arkorobotics/L1DemosceneBoard/L1Demo-C-example/L1DemoProto.X/README.md

# Layer 1 demo board code

This is where I'll be dumping my L1 Demo code as I slowly cobble it together.
See https://github.com/arkorobotics/L1DemosceneBoard for more examples.
