arkorobotics/L1DemosceneBoard/L1Demo-PCB/arko_l1demo_partlist.xlsx

Partlist
Exported | from | L1Demoscene_v4.brd | at | 2014-12-15 | 7:47:11 | PM
EAGLE | Version | 6.5.0 | Copyright | (c) | 1988-2013 | CadSoft
Assembly | variant:
Part | Value | Package | Library | Position | (mil) | Orientation
C1 | 0.1uF | 0603-CAP | SparkFun-Capacitors | (550 | 1290) | R90
C2 | 10uF | EIA3216 | SparkFun-Capacitors | (120 | 220) | R0
C3 | EIA3216 | SparkFun-Capacitors | (1430 | 1790) | R270
C4 | SMC_A | dp_devices | (270 | 1690) | R90
C5 | SMC_A | dp_devices | (370 | 1690) | R90
C6 | 18pF | 0603-CAP | SparkFun-Capacitors | (90 | 460) | R180
C7 | 18pF | 0603-CAP | SparkFun-Capacitors | (90 | 780) | R0
C8 | 0.1uF | 0603-CAP | SparkFun-Capacitors | (750 | 980) | R180
C9 | 0.1uF | 0603-CAP | SparkFun-Capacitors | (90 | 860) | R180
C10 | 0.1uF | 0603-CAP | SparkFun-Capacitors | (480 | 190) | R180
C11 | 0.1uF | 0603-CAP | SparkFun-Capacitors | (870 | 590) | R90
IC2 | REG1117 | SOT223 | burr-brown | (370 | 1390) | R180
L1 | 30Ohm,1.8A | 603 | SparkFun-Passives | (750 | 1050) | R180
PWR | LED-603 | dp_devices | (530 | 1690) | R180
R1 | 2K | 0603-RES | SparkFun-Resistors | (1130 | 1150) | R0
R2 | 10K | 0603-RES | SparkFun-Resistors | (90 | 380) | R0
R3 | 470 | 0603-RES | SparkFun-Resistors | (90 | 310) | R180
R6 | 10k | 0603-RES | SparkFun-Resistors | (1030 | 1660) | R90
R7 | 10k | 0603-RES | SparkFun-Resistors | (930 | 1660) | R90
R18 | 10k | 0603-RES | SparkFun-Resistors | (1130 | 1660) | R90
R27 | 1k | 0603-RES | SparkFun-Resistors | (460 | 1690) | R270
R28 | 10k | 0603-RES | SparkFun-Resistors | (1230 | 1660) | R90
RESET | SWITCH-MOMENTARY-2-SMD-1101NE | TACTILE-SWITCH-1101NE | SparkFun-Electromechanical | (930 | 80) | R180
RN1 | 560 | EXB2HV | resistor-dil | (1130 | 570) | R270
RN2 | 270 | EXB2HV | resistor-dil | (1350 | 570) | R270
RN3 | 560 | EXB2HV | resistor-dil | (1130 | 890) | R270
RN4 | 270 | EXB2HV | resistor-dil | (1350 | 890) | R270
RN5 | 560 | EXB2HV | resistor-dil | (1130 | 250) | R270
RN6 | 270 | EXB2HV | resistor-dil | (1350 | 250) | R270
RN7 | 2K | EXB2HV | resistor-dil | (1130 | 1290) | R270
RN8 | 1K | EXB2HV | resistor-dil | (1350 | 1290) | R270
S3 | SWITCH-SPST-SMD-A | SparkFun-Electromechanical | (60 | 1670) | R90
U2 | PIC24FXXXDAX06 | PIC24FXXX_TQFP64 | SparkFun-DigitalIC | (510 | 510) | R90
U3 | USB-AB-MICRO-SMD | SparkFun-Connectors | (80 | 1120) | R0
Y1 | CRYSTAL-SMD-5X3 | SparkFun-FreqCtrl | (90 | 620) | R270
