arkorobotics/L1DemosceneBoard/L1Demo-PCB/L1Demoboard_BOM.xlsx

Part | Value | Device | Package | Description | Link | QTY | 100 Boards | 50 Boards
C1,C8,C9,C10,C11 | 0.1uF | CAP0603-CAP | 0603-CAP | Capacitor | http://www.digikey.com/product-detail/en/GRM188R71C104KA01D/490-1532-1-ND/587771 | 5 | 3.00 | 1.76
C2,C3,C4,C5 | 10uF | CAP_POL1206 | EIA3216 | Capacitor | http://www.digikey.com/product-detail/en/T491A106K010AT/399-3684-1-ND/819009 | 4 | 53.87 | 33.68 | EXPENSIVE
C6,C7 | 18pF | CAP0603-CAP | 0603-CAP | Capacitor | http://www.digikey.com/product-detail/en/GRM1885C1H180JA01D/490-1409-1-ND/587631 | 2 | 3.82 | 1.91
IC2 | REG1117 | REG1117 | SOT223 | 800mA | http://www.digikey.com/product-detail/en/LM1117MPX-3.3%2FNOPB/LM1117MPX-3.3%2FNOPBCT-ND/1010516 | 1 | 115.16 | 65.80 | EXPENSIVE
J2 | CON_HEADER_1X02-PTH | CON_HEADER_1X02-PTH | M1X2 |  | http://www.digikey.com/product-detail/en/67997-210HLF/609-3236-ND/1878541 | 1 | 10.40 | 5.60
J3 | CON_HEADER_2X04-PTH | CON_HEADER_2X04-PTH | M2X5 |  | http://www.digikey.com/product-detail/en/67997-210HLF/609-3236-ND/1878541 | 1 | 35.40 | 18.47
JP1 | AUDIO-JACKPTH | AUDIO-JACK | 3.5mm | Audio | http://www.digikey.com/product-detail/en/SJ1-3525N/CP1-3525N-ND/738687 | 1 | 0.00 | 0.00 | EXPENSIVE
JP2 | M06SIP | 1X06 | Header | 6 | http://www.digikey.com/product-detail/en/961106-5604-AR/3M9471-ND/2071512 | 1 | 32.20 | 16.80
L1 | 30Ohm,1.8A | INDUCTOR0402 | C0402 | Inductors | http://www.digikey.com/product-detail/en/ELJ-PF2N7DFB/PCD1890CT-ND/762119 | 1 | 13.06 | 6.99
PWR | LED-0603 | LED-603 | Light | Emitting | http://www.digikey.com/product-detail/en/LTST-C191KRKT/160-1447-1-ND/386836 | 1 | 12.96 | 11.90
R1 | 2K | RESISTOR0603-RES | 0603-RES | Resistor | http://www.digikey.com/scripts/DkSearch/dksus.dll?Detail&itemSeq=157261085&uq=635461678349767670 | 1 | 1.14 | 0.75
R2,R6,R7,R18,R28 | 10K | RESISTOR0603-RES | 0603-RES | Resistor | http://www.digikey.com/product-detail/en/RC0603JR-0710KL/311-10KGRCT-ND/729647 | 5 | 0.45 | 0.40
R3 | 470 | RESISTOR0603-RES | 0603-RES | Resistor | http://www.digikey.com/product-detail/en/RC0603JR-07470RL/311-470GRCT-ND/729738 | 1 | 0.45 | 0.40
R27 | 1k | RESISTOR0603-RES | 0603-RES | Resistor | http://www.digikey.com/product-detail/en/RC0603FR-071KL/311-1.00KHRCT-ND/729790 | 1 | 0.60 | 0.54
RN1,RN3,RN5 | 560 | 8R-NEXB2HV | EXB2HV | DIL | http://www.digikey.com/product-detail/en/EXB-2HV561JV/Y1561CT-ND/285378 | 3 | 39.37 | 25.32
RN2,RN4,RN6 | 270 | 8R-NEXB2HV | EXB2HV | DIL | http://www.digikey.com/product-detail/en/EXB-2HV271JV/Y1271CT-ND/285374 | 3 | 39.37 | 25.32
RN7 | 2K | 8R-NEXB2HV | EXB2HV | DIL | http://www.digikey.com/product-detail/en/EXB-2HV222JV/Y1222CT-ND/285385 | 1 | 16.88 | 10.94
RN8 | 1K | 8R-NEXB2HV | EXB2HV | DIL | http://www.digikey.com/scripts/DkSearch/dksus.dll?Detail&itemSeq=157261141&uq=635461681129495907 | 1 | 16.88 | 10.94
S3 | SWITCH-SPDT-SMD-A | SWITCH-SPST-SMD-A | SPDT | Switch | http://www.digikey.com/scripts/DkSearch/dksus.dll?Detail&itemSeq=157261168&uq=635461682841907907 | 1 | 62.26 | 32.69
U$1 | DB15 | DB15 | DB15 | DB15 | http://www.digikey.com/product-detail/en/1734344-1/A35119-ND/1279832 | 1 | 0.00 | 0.00
U2 | PIC24FJ256DA206 | PIC24FXXXDAX06 | PIC24FXXX_TQFP64 | PIC24FXXXDAX06 | http://www.mouser.com/Search/ProductDetail.aspx | 1 | 584.00 | 322.50 | EXPENSIVE
U3 | USB-AB | USB-AB-MICRO-SMD | This | is | http://www.digikey.com/product-detail/en/10104111-0001LF/609-4053-1-ND/2350359 | 1 | 56.87 | 29.67
Y1 | CRYSTAL5X3 | CRYSTAL-SMD-5X3 | Various | standard | http://www.digikey.com/product-search/en?KeyWords=535-9720-1-ND&WT.z_header=search_go | 1 | 76.00 | 42.94
 | Push Switch |  |  |  | http://www.digikey.com/product-detail/en/RS-282G05A3-SM%20RT/CKN10384CT-ND/2747203 | 1 | 55.00 | 30.25 | EXPENSIVE
 |  |  |  |  |  |  | Total part cost of 100 Boards | Total part cost of 50 Boards
 |  |  |  |  |  |  | 1229.14 | 695.57
 |  |  |  |  |  |  | Part cost per board | Part cost per board
 |  |  |  |  |  |  | 12.29144 | 13.9114
 |  |  |  |  |  |  | PNP total cost | PNP total cost
 |  |  |  |  |  |  | 900 | 525
 |  |  |  |  |  |  | PNP cost per board | PNP cost per board
 |  |  |  |  |  |  | 6.5 | 10.5
 |  |  |  |  |  |  | PCB cost | PCB cost
 |  |  |  |  |  |  | 198 | 70
 |  |  |  |  |  |  | Total cost to manufacture 100 | Total cost to manufacture 50
 |  |  |  |  |  |  | 2327.14 | 1290.57
 |  |  |  |  |  |  | Total cost per board | Total cost per board
 |  |  |  |  |  |  | 23.27144 | 25.8114
