arkorobotics/L1DemosceneBoard/L1Demo-PCB/L1Demoscene_v4.pdf

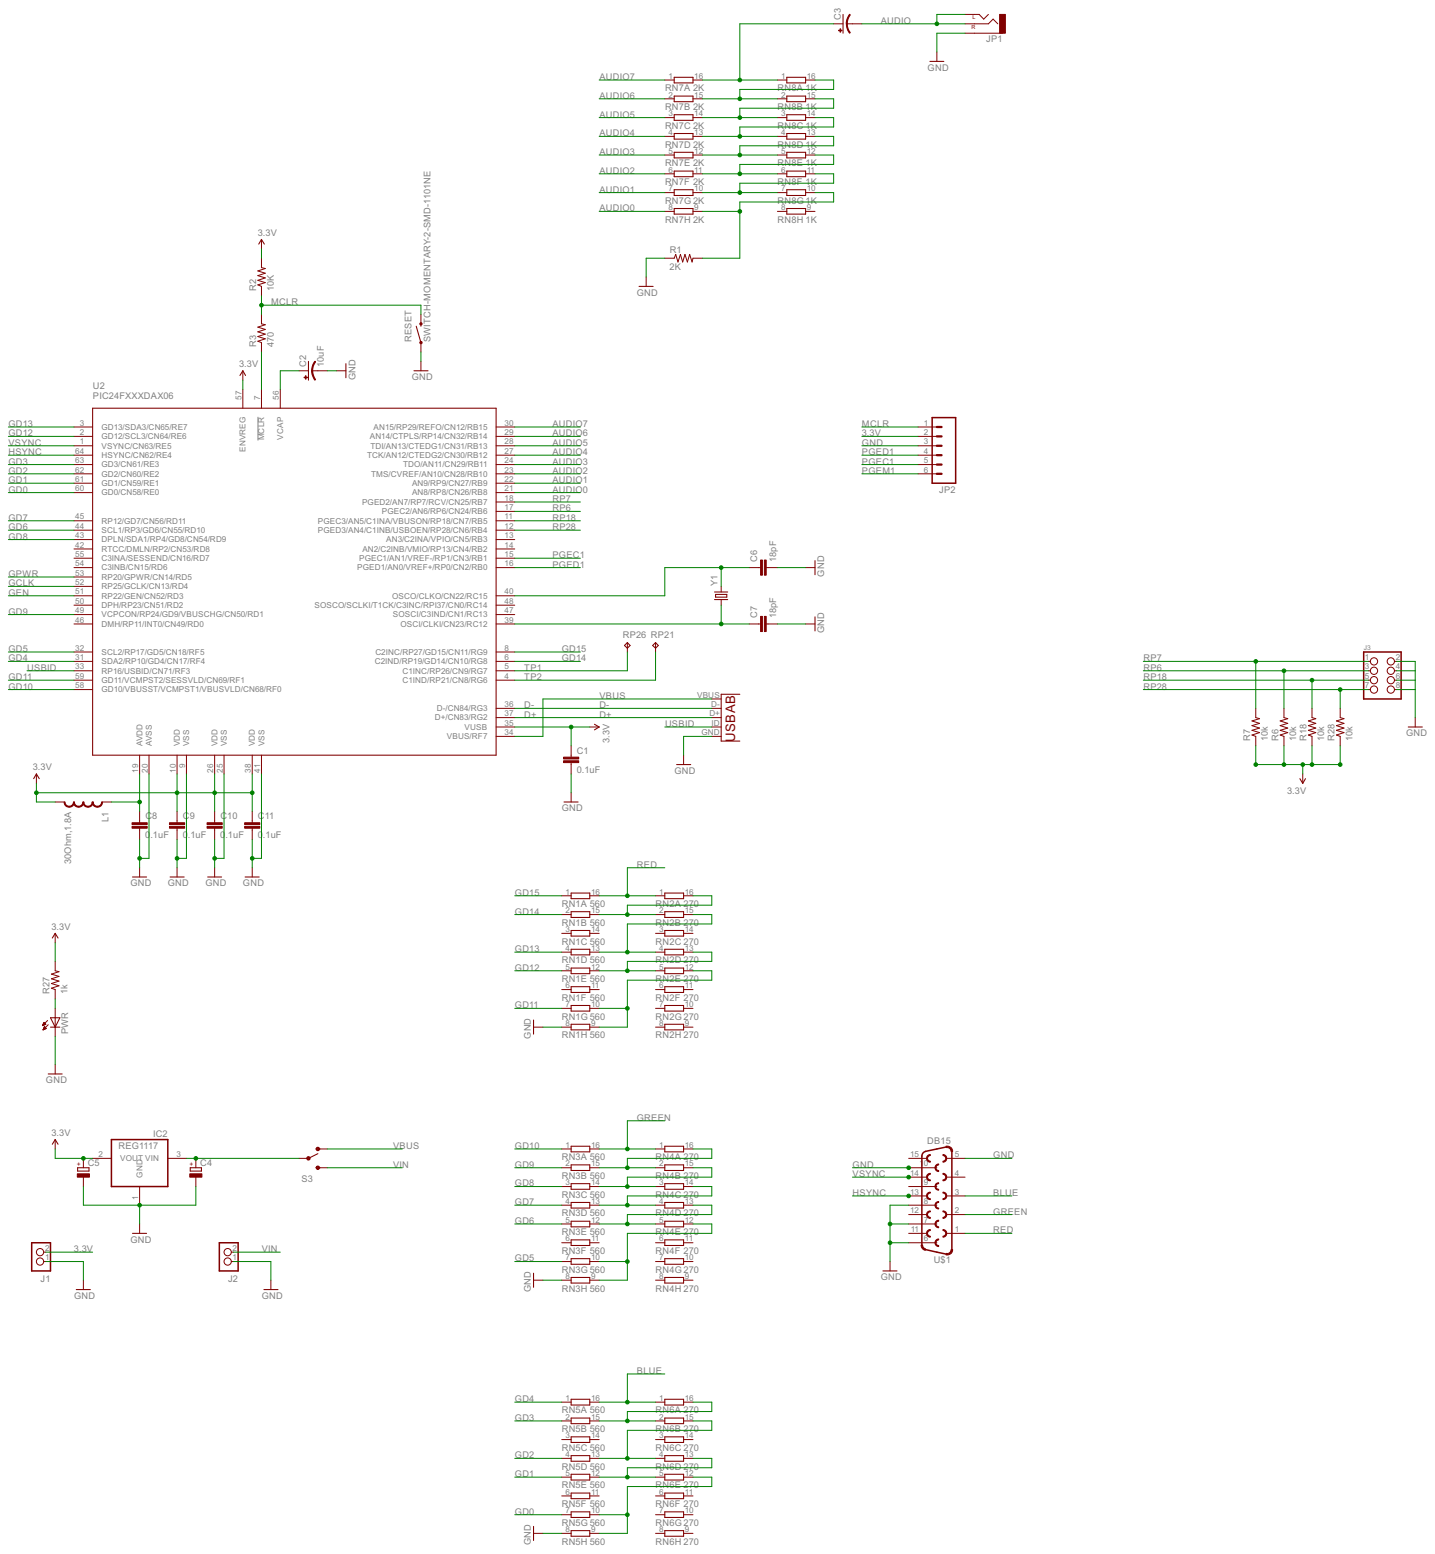
[picture p1: page 1]
