arkorobotics/L1DemosceneBoard/L1Demo-PCB/L1Demoscene_v4.brd

## EAGLE design L1Demo-PCB/L1Demoscene_v4.brd (2015-01-01)

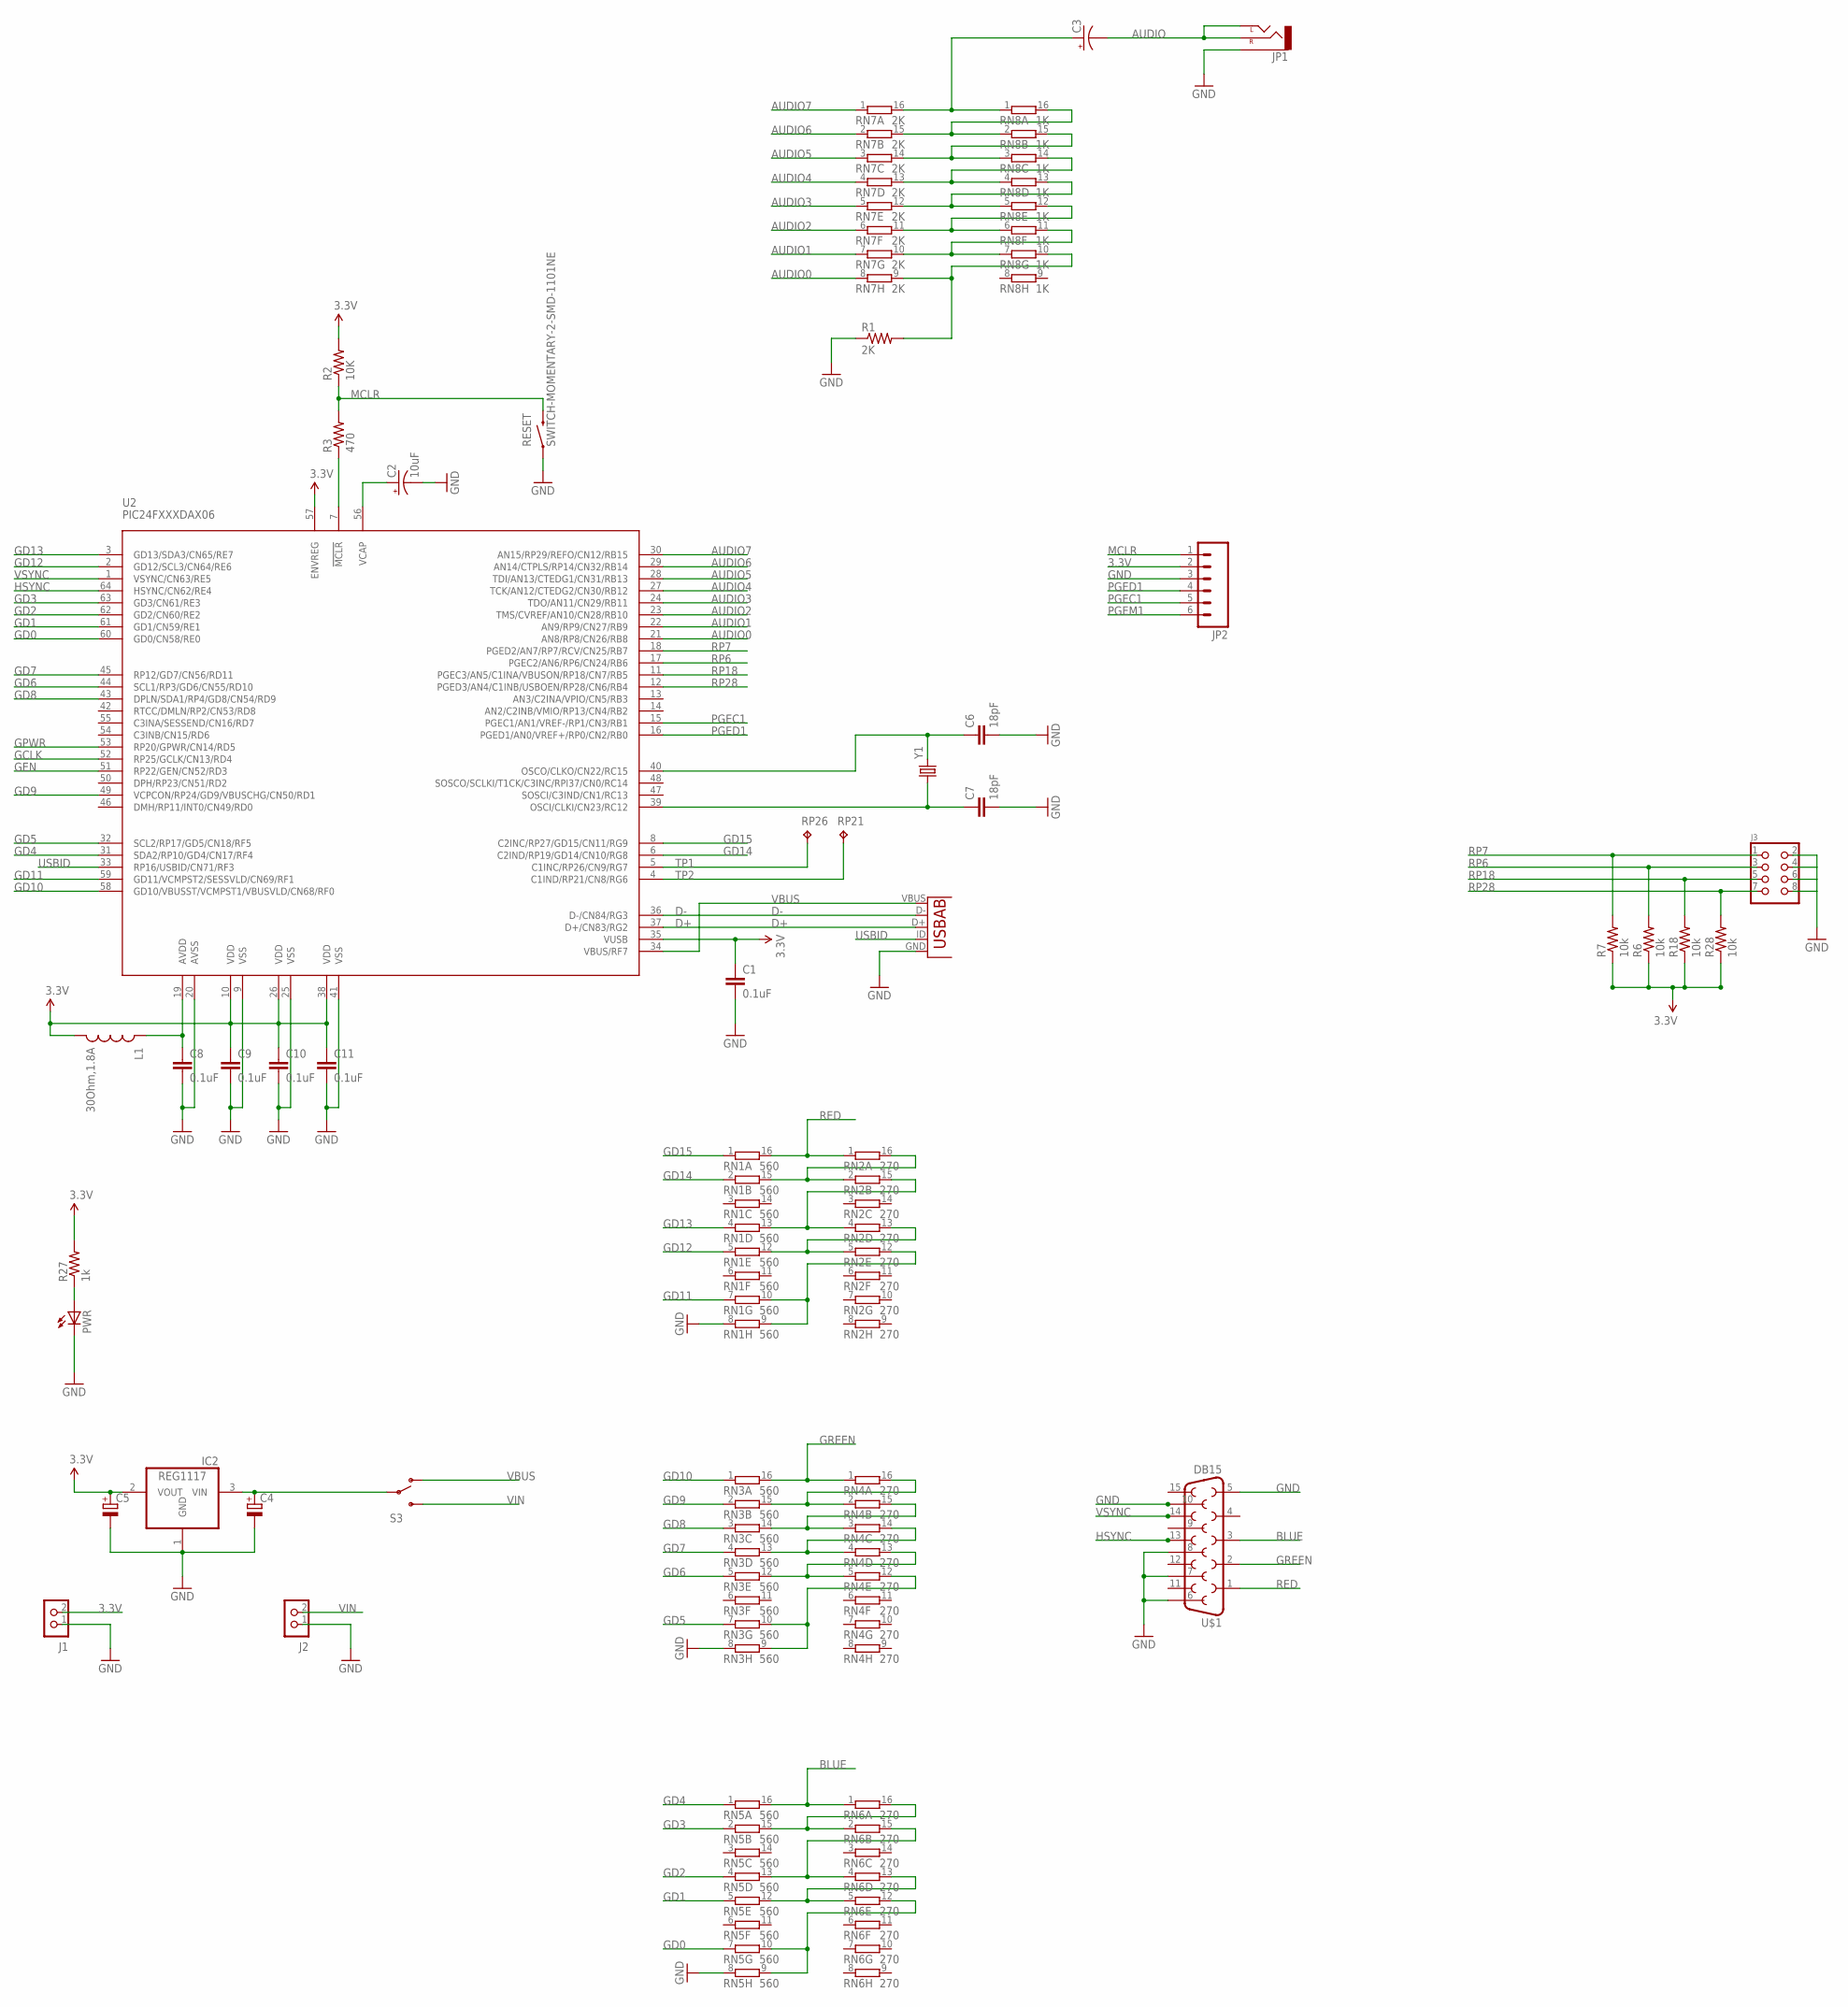
[picture p2: schematic L1Demoscene_v4.sch]

Parts:
C1, C8, C9, C10, C11: 0.1uF; 0603-CAP
C2: 10uF; EIA3216
C3: CAP_POL1206; EIA3216
C4, C5: CAPACITOR_POL-SMC_A; SMC_A
C6, C7: 18pF; 0603-CAP
IC2: REG1117; SOT223
J1, J2: CON_HEADER_1X02-PTH; M1X2
J3: CON_HEADER_2X04-PTH; M2X4
JP1: AUDIO-JACKPTH; AUDIO-JACK
JP2: M06SIP; 1X06
L1: 30Ohm,1.8A; 0603
PWR: LED-0603; LED-603
R1: 2K; 0603-RES
R2: 10K; 0603-RES
R3: 470; 0603-RES
R6, R7, R18, R28: 10k; 0603-RES
R27: 1k; 0603-RES
RESET: SWITCH-MOMENTARY-2-SMD-1101NE; TACTILE-SWITCH-1101NE
RN1, RN3, RN5: 560; EXB2HV
RN2, RN4, RN6: 270; EXB2HV
RN7: 2K; EXB2HV
RN8: 1K; EXB2HV
RP21, RP26: TPTP06R; TP06R
S3: SWITCH-SPDT-SMD-A; SWITCH-SPST-SMD-A
U2: PIC24FXXXDAX06; PIC24FXXX_TQFP64
U3: USB-AB; USB-AB-MICRO-SMD
U$1: DB15
Y1: CRYSTAL5X3; CRYSTAL-SMD-5X3

Connections:
3.3V: C1.1, C5.+, C9.1, C10.1, C11.1, IC2.2 (VOUT), J1.2, JP2.2, L1.2, R2.2, R6.1, R7.1, R18.1, R27.2, R28.1, U2.10 (VDD), U2.26 (VDD), U2.35 (VUSB), U2.38 (VDD), U2.57 (ENVREG)
AUDIO: C3.C (-), JP1.RING (RIGHT), JP1.TIP (LEFT)
AUDIO0: RN7.8 (1), U2.21 (AN8/RP8/CN26/RB8)
AUDIO1: RN7.7 (1), U2.22 (AN9/RP9/CN27/RB9)
AUDIO2: RN7.6 (1), U2.23 (TMS/CVREF/AN10/CN28/RB10)
AUDIO3: RN7.5 (1), U2.24 (TDO/AN11/CN29/RB11)
AUDIO4: RN7.4 (1), U2.27 (TCK/AN12/CTEDG2/CN30/RB12)
AUDIO5: RN7.3 (1), U2.28 (TDI/AN13/CTEDG1/CN31/RB13)
AUDIO6: RN7.2 (1), U2.29 (AN14/CTPLS/RP14/CN32/RB14)
AUDIO7: RN7.1, U2.30 (AN15/RP29/REFO/CN12/RB15)
BLUE: RN5.16 (2), RN6.1, U$1.3
D+: U2.37 (D+/CN83/RG2), U3.D+
D-: U2.36 (D-/CN84/RG3), U3.D-
GCLK: U2.52 (RP25/GCLK/CN13/RD4)
GD0: RN5.7 (1), U2.60 (GD0/CN58/RE0)
GD1: RN5.5 (1), U2.61 (GD1/CN59/RE1)
GD2: RN5.4 (1), U2.62 (GD2/CN60/RE2)
GD3: RN5.2 (1), U2.63 (GD3/CN61/RE3)
GD4: RN5.1, U2.31 (SDA2/RP10/GD4/CN17/RF4)
GD5: RN3.7 (1), U2.32 (SCL2/RP17/GD5/CN18/RF5)
GD6: RN3.5 (1), U2.44 (SCL1/RP3/GD6/CN55/RD10)
GD7: RN3.4 (1), U2.45 (RP12/GD7/CN56/RD11)
GD8: RN3.3 (1), U2.43 (DPLN/SDA1/RP4/GD8/CN54/RD9)
GD9: RN3.2 (1), U2.49 (VCPCON/RP24/GD9/VBUSCHG/CN50/RD1)
GD10: RN3.1, U2.58 (GD10/VBUSST/VCMPST1/VBUSVLD/CN68/RF0)
GD11: RN1.7 (1), U2.59 (GD11/VCMPST2/SESSVLD/CN69/RF1)
GD12: RN1.5 (1), U2.2 (GD12/SCL3/CN64/RE6)
GD13: RN1.4 (1), U2.3 (GD13/SDA3/CN65/RE7)
GD14: RN1.2 (1), U2.6 (C2IND/RP19/GD14/CN10/RG8)
GD15: RN1.1, U2.8 (C2INC/RP27/GD15/CN11/RG9)
GEN: U2.51 (RP22/GEN/CN52/RD3)
GND: C1.2, C2.C (-), C4.-, C5.-, C6.2, C7.2, C8.2, C9.2, C10.2, C11.2, IC2.1 (GND), J1.1, J2.1, J3.2, J3.4, J3.6, J3.8, JP1.SLEEVE, JP2.3, PWR.C, R1.1, RESET.P$1 (1), RN1.8 (1), RN3.8 (1), RN5.8 (1), U2.9 (VSS), U2.20 (AVSS), U2.25 (VSS), U2.41 (VSS), U3.GND, U$1.5, U$1.6, U$1.7, U$1.8, U$1.10
GPWR: U2.53 (RP20/GPWR/CN14/RD5)
GREEN: RN3.16 (2), RN4.1, U$1.2
HSYNC: U2.64 (HSYNC/CN62/RE4), U$1.13
MCLR: JP2.1, R2.1, R3.2, RESET.P$2 (2)
unnamed: C8.1, L1.1, U2.19 (AVDD)
unnamed: C3.A (+), RN7.16 (2), RN8.1
unnamed: C7.1, U2.39 (OSCI/CLKI/CN23/RC12), Y1.1
unnamed: R3.1, U2.7 (!MCLR)
unnamed: RN7.15 (2), RN8.2 (1), RN8.16 (2)
unnamed: RN7.14 (2), RN8.3 (1), RN8.15 (2)
unnamed: C4.+, IC2.3 (VIN), S3.2
unnamed: C2.A (+), U2.56 (VCAP)
unnamed: RN7.13 (2), RN8.4 (1), RN8.14 (2)
unnamed: PWR.A, R27.1
unnamed: RN7.12 (2), RN8.5 (1), RN8.13 (2)
unnamed: RN7.11 (2), RN8.6 (1), RN8.12 (2)
unnamed: RN7.10 (2), RN8.7 (1), RN8.11 (2)
unnamed: RN3.15 (2), RN4.2 (1), RN4.16 (2)
unnamed: RN3.14 (2), RN4.3 (1), RN4.15 (2)
unnamed: RN3.13 (2), RN4.4 (1), RN4.14 (2)
unnamed: RN3.12 (2), RN4.5 (1), RN4.13 (2)
unnamed: RN3.9 (2), RN3.10 (2), RN4.12 (2)
unnamed: R1.2, RN7.9 (2), RN8.10 (2)
unnamed: C6.1, U2.40 (OSCO/CLKO/CN22/RC15), Y1.3 (2)
unnamed: RN1.13 (2), RN2.4 (1), RN2.15 (2)
unnamed: RN1.15 (2), RN2.2 (1), RN2.16 (2)
unnamed: RN1.12 (2), RN2.5 (1), RN2.13 (2)
unnamed: RN1.9 (2), RN1.10 (2), RN2.12 (2)
unnamed: RN5.15 (2), RN6.2 (1), RN6.16 (2)
unnamed: RN5.13 (2), RN6.4 (1), RN6.15 (2)
unnamed: RN5.12 (2), RN6.5 (1), RN6.13 (2)
unnamed: RN5.9 (2), RN5.10 (2), RN6.12 (2)
PGEC1: JP2.5, U2.15 (PGEC1/AN1/VREF-/RP1/CN3/RB1)
PGED1: JP2.4, U2.16 (PGED1/AN0/VREF+/RP0/CN2/RB0)
PGEM1: JP2.6
RED: RN1.16 (2), RN2.1, U$1.1
RP6: J3.3, R6.2, U2.17 (PGEC2/AN6/RP6/CN24/RB6)
RP7: J3.1, R7.2, U2.18 (PGED2/AN7/RP7/RCV/CN25/RB7)
RP18: J3.5, R18.2, U2.11 (PGEC3/AN5/C1INA/VBUSON/RP18/CN7/RB5)
RP28: J3.7, R28.2, U2.12 (PGED3/AN4/C1INB/USBOEN/RP28/CN6/RB4)
TP1: RP26.TP, U2.5 (C1INC/RP26/CN9/RG7)
TP2: RP21.TP, U2.4 (C1IND/RP21/CN8/RG6)
USBID: U2.33 (RP16/USBID/CN71/RF3), U3.ID (USBID)
VBUS: S3.1 (O), U2.34 (VBUS/RF7), U3.VBUS
VIN: J2.2, S3.3 (S)
VSYNC: U2.1 (VSYNC/CN63/RE5), U$1.14

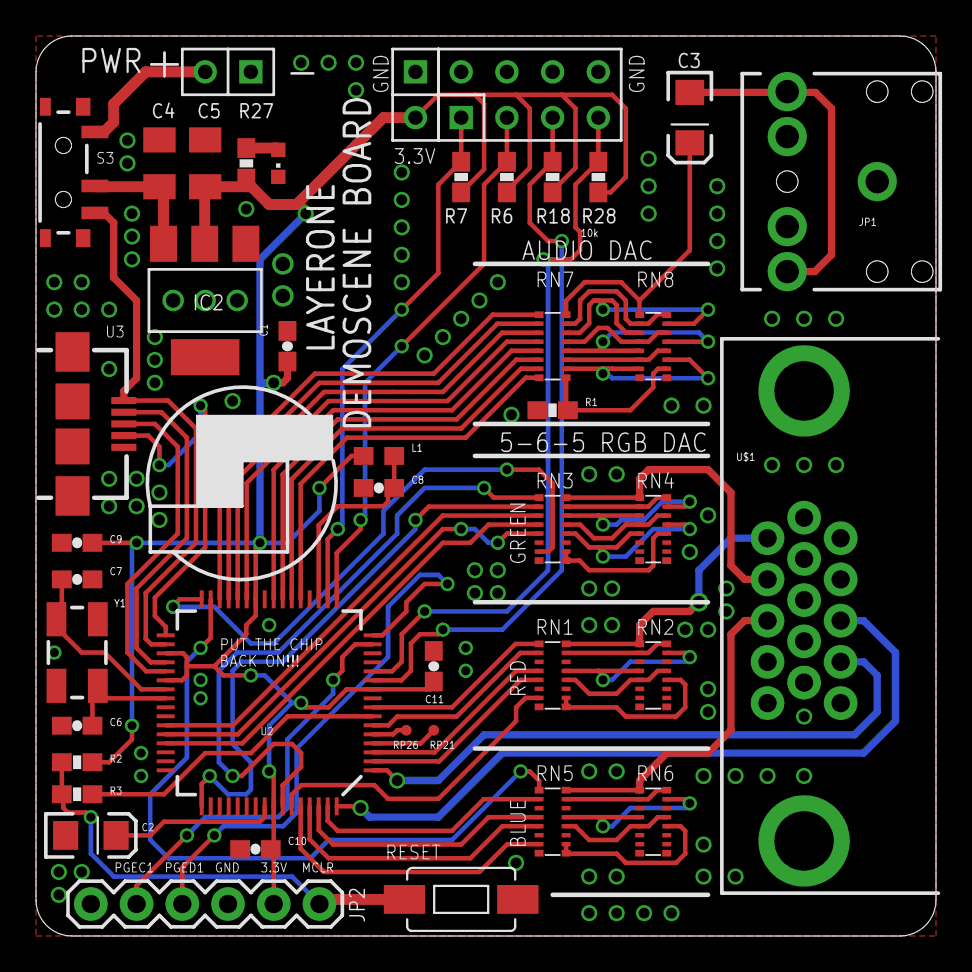
[picture p3: board L1Demoscene_v4.brd from above]

Board: 2 copper layers, 50.0 x 50.0 mm, 44 parts (0 on the bottom side), 74 nets.

Other parts of the board:
U$2: STM32-PROX_L1LOGO
