arkorobotics/L1DemosceneBoard/L1Demo-C-example/L1DemoProto.X/clut/main.c

#include <stdint.h>
#include <stdio.h>
#include <stdlib.h>
#include <xc.h>
#include <string.h>
#include <math.h>

#define  FCY    16000000UL    // Instruction cycle frequency, Hz
#include <libpic30.h>

_CONFIG1(FWDTEN_OFF & GWRP_OFF & GCP_OFF & JTAGEN_OFF)
_CONFIG2(POSCMOD_HS & FCKSM_CSDCMD & FNOSC_PRIPLL & PLL96MHZ_ON & PLLDIV_DIV2)
_CONFIG3(ALTPMP_ALTPMPEN & SOSCSEL_EC)

/*
   To change resolutions, use an X modeline generator like:
   http://xtiming.sourceforge.net/cgi-bin/xtiming.pl
   For example, 80x480@60Hz produces
   Modeline "80x480@61" 4.93 80 112 128 160 480 490 495 505
   Then we convert it to the values we need:

   4.93 is the pixel clock in MHz, we need to set CLOCKDIV to match.  To pick a
   divisor, use page 147 of the data sheet or, uh, this perl one-liner to
   generate all of them and pick one that's close:
   perl -e '$d = 1;  $x = 0; while($x < 128) { printf "%s %.2f\n",$x,96/$d;if($x < 64) { $d += 0.25; } elsif($x < 96) { $d += 0.50 } else { $d += 1 }; $x++}'

   The differences between: 80 112 128 160 480
   are H-porch, H-Pulse, H-width
   The differences between: 480 490 495 505
   are V-porch, V-Pulse, V-width

   Once these values are in, the monitor will display it but it will probably
   be misaligned (especially vertically).  Play with VENST_FUDGE and
   HENST_FUDGE to fix this.
*/

#define HOR_RES 640UL
#define VER_RES 480UL
#define HOR_FRONT_PORCH 16
#define HOR_PULSE_WIDTH 96
#define HOR_BACK_PORCH  48
#define VER_FRONT_PORCH 10
#define VER_PULSE_WIDTH 2
#define VER_BACK_PORCH  33
#define BPP 1
#define CLOCKDIV 11
#define VENST_FUDGE 0
#define HENST_FUDGE 0
#define VSPOL 0 /* sync polarities */
#define HSPOL 0

#define CHR_FGCOLOR		0x5000
#define CHR_BGCOLOR		0x5100
#define CHR_FONTBASE		0x5200
#define CHR_PRINTCHAR		0x5300
#define CHR_TXTAREASTART	0x5800
#define CHR_TXTAREAEND		0x5900
#define CHR_PRINTPOS		0x5A00
#define RCC_SRCADDR	 	0x6200
#define RCC_DESTADDR	 	0x6300
#define RCC_RECTSIZE	 	0x6400
#define RCC_COLOR	 	0x6600
#define RCC_STARTCOPY	 	0x6700
#define IPU_SRCADDR		0x7100
#define IPU_DESTADDR	 	0x7200
#define IPU_DECOMPRESS	 	0x7400

#define GFX_BUFFER_SIZE (HOR_RES * VER_RES / (8/BPP))
__eds__ uint8_t GFXDisplayBuffer[2][GFX_BUFFER_SIZE] __attribute__((eds, section("DISPLAY"), address(0x1000)));

void config_graphics(void) {
	_G1CLKSEL = 1;
	_GCLKDIV = CLOCKDIV;

	G1DPADRL = (unsigned long)(GFXDisplayBuffer) & 0xFFFF;
	G1DPADRH = (unsigned long)(GFXDisplayBuffer) >>16 & 0xFF;
	G1W1ADRL = (unsigned long)(GFXDisplayBuffer) & 0xFFFF;
	G1W1ADRH = (unsigned long)(GFXDisplayBuffer) >>16 & 0xFF;
	G1W2ADRL = (unsigned long)(GFXDisplayBuffer) & 0xFFFF;
	G1W2ADRH = (unsigned long)(GFXDisplayBuffer) >>16 & 0xFF;

	_GDBEN = 0xFFFF;

	// Using PIC24F manual section 43 page 37-38
	_DPMODE = 1;      /* TFT */
	_GDBEN = 0xFFFF;
	_DPW = _PUW = HOR_RES; // Work area and FB size so GPU works
	_DPH = _PUH = VER_RES;
	_DPWT = HOR_FRONT_PORCH + HOR_PULSE_WIDTH + HOR_BACK_PORCH + HOR_RES;
	_DPHT = VER_FRONT_PORCH + VER_PULSE_WIDTH + VER_BACK_PORCH + VER_RES;
	_DPCLKPOL = 0;
	_DPENOE = 0;
	_DPENPOL = 0;
	_DPVSOE = 1;
	_DPHSOE = 1;
	_DPVSPOL = VSPOL;
	_DPHSPOL = HSPOL;
	_ACTLINE = _VENST = VER_FRONT_PORCH + VER_PULSE_WIDTH + VER_BACK_PORCH - VENST_FUDGE;
	_ACTPIX = _HENST = HOR_FRONT_PORCH + HOR_PULSE_WIDTH + HOR_BACK_PORCH - HENST_FUDGE;
	_VSST = VER_FRONT_PORCH;
	_HSST = HOR_FRONT_PORCH;
	_VSLEN = VER_PULSE_WIDTH;
	_HSLEN = HOR_PULSE_WIDTH;
	_DPPWROE = 0;
	_DPPINOE = 1;
	_DPPOWER = 1;
	_DPBPP = _PUBPP = BPP / 2;


//	_DPTEST = 2; /* Uncomment for test patterns */

	_G1EN = 1;
	__delay_ms(1);
}

void rcc_color(char color) {
	while(_CMDFUL) continue;
	G1CMDL = color;
	G1CMDH = RCC_COLOR;
	Nop();
}

void rcc_setdest(__eds__ uint8_t *buf) {
	while(!_CMDMPT) continue; // Wait for GPU to finish drawing
	G1W2ADRL = (unsigned long)(buf);
	G1W2ADRH = (unsigned long)(buf);
}

void gpu_setfb(__eds__ uint8_t *buf) {
	while(!_CMDMPT) continue; // Wait for GPU to finish drawing
	G1DPADRL = (unsigned long)(buf);
	G1DPADRH = (unsigned long)(buf);
}

void rcc_draw(uint16_t x, uint16_t y, uint16_t w, uint16_t h) {
	// destination
	while(_CMDFUL) continue;
	G1CMDL = x + y*HOR_RES;
	G1CMDH = RCC_DESTADDR | (x + y*HOR_RES)>>16;
	Nop();

	// size
	while(_CMDFUL) continue;
	G1CMDL = (w<<12) | h;
	G1CMDH = RCC_RECTSIZE | (w>>4);
	Nop();

	// go!
	while(_CMDFUL) continue;
	G1CMDL = 0xC<<3;
	G1CMDH = RCC_STARTCOPY;
	Nop();
}

void blank_background() {
	rcc_color(0);
	rcc_draw(0, 0, HOR_RES, VER_RES);
}

void config_clut() {
	_CLUTADR = 0; // set 0 to black
	_CLUTRWEN = 1;
	G1CLUTWR = 0;
	while(_CLUTBUSY) continue;
	_CLUTADR = 1; // set 1 to blue
	G1CLUTWR = 0xFF;
	while(_CLUTBUSY) continue;
	_CLUTRWEN = 0;
	_CLUTEN = 1; // let 'er rip!
}

void clut_set(int index, int color) {
	_CLUTADR = index;
	_CLUTRWEN = 1;
	G1CLUTWR = color;
	while(_CLUTBUSY) continue;
	_CLUTRWEN = 0;
}


int colors[VER_FRONT_PORCH + VER_PULSE_WIDTH + VER_BACK_PORCH + VER_RES];
void calc_colors() {
	int x;
	for(x = 0; x < sizeof(colors)/sizeof(colors[0]); x++) {
		colors[x] = rand();
	}
}

void __attribute__((interrupt, auto_psv))_GFX1Interrupt(void) {
	static int lines = 0;
	static int syncs = 0;
	if(_VMRGNIF) { /* on a vertical sync, flip buffers every 60hz */
		lines = 0;
		syncs++;
		gpu_setfb(GFXDisplayBuffer[(syncs / 60) % 2]);
		_VMRGNIF = 0;
	} else if(_HMRGNIF) { /* on each horizontal sync, change clut */
		clut_set(1, colors[lines]);
//		clut_set(1, rand()); // madness!
		lines++;
		_HMRGNIF = 0;
	}
	_GFX1IF = 0;
}

int main(void) {
	int x;
	//OSCCON = 0x0000;

	ANSB = 0x0000;
	ANSC = 0x0000;
	ANSD = 0x0000;
	ANSF = 0x0000;
	ANSG = 0x0000;
	//TRISE = 0x0000;

	TRISB = 0x0000;

	config_graphics();
	config_clut();
	calc_colors();

	// clear buffers
	rcc_setdest(GFXDisplayBuffer[0]);
	blank_background();
	rcc_setdest(GFXDisplayBuffer[1]);
	blank_background();

	// draw alternating lines in our two buffers
	rcc_setdest(GFXDisplayBuffer[0]);
	rcc_color(1);
	for(x = 0; x < VER_RES; x += 2) {
		rcc_draw(0, x, HOR_RES, 1);
	}
	rcc_color(0);
	rcc_draw(HOR_RES - 1, 0, 1, VER_RES);
	rcc_color(1);
	rcc_setdest(GFXDisplayBuffer[1]);
	for(x = 1; x < VER_RES; x += 2) {
		rcc_draw(0, x, HOR_RES, 1);
	}
	rcc_color(0);
	rcc_draw(HOR_RES - 1, 0, 1, VER_RES);
	while(!_CMDMPT) continue; // Wait for GPU to finish drawing

	_VMRGNIF = 0;
	_HMRGNIF = 0;
	_HMRGNIE = 1;
	_VMRGNIE = 1;
	_GFX1IE = 1;

	while (1) {
	}

	return 0;
}
