arkorobotics/L1DemosceneBoard/L1Demo-C-example/L1DemoProto.X/screens.h

__prog__ uint8_t SnoopOne[] __attribute__((space(prog))) = {
0xcf, 0xef, 0xef, 0xef, 0xcf, 0xd3, 0xd3, 0xd3, 0xb3, 0xb3, 0xb3, 0xb3, 0xb3, 0xd3, 0xb3, 0xd3, 0xd3, 0xd3, 0xd3, 0xd3,
0xd3, 0xd3, 0xd3, 0xd3, 0xd3, 0xd3, 0xd3, 0xd3, 0xd7, 0xd7, 0x0, 0x21, 0x1, 0x1, 0x0, 0x0, 0x0, 0x0, 0x0, 0x0,
0x0, 0x0, 0x0, 0x0, 0x0, 0x0, 0x0, 0x0, 0x4, 0x24, 0x4, 0x24, 0x68, 0x49, 0x45, 0x0, 0x0, 0x0, 0x0, 0x0,
0x0, 0x0, 0x0, 0x0, 0x0, 0x1, 0x0, 0x0, 0x0, 0x1, 0x21, 0x1, 0xd7, 0xb7, 0xb3, 0xb3, 0xb3, 0xb3, 0xb3, 0xb3,
0xcf, 0xef, 0xef, 0xef, 0xcf, 0xd3, 0xd3, 0xd3, 0xd3, 0xd3, 0xb3, 0xb3, 0xb3, 0xd3, 0xb3, 0xd3, 0xd3, 0xd3, 0xd3, 0xd3,
0xd3, 0xd3, 0xd3, 0xd3, 0xd3, 0xf3, 0xf3, 0xd3, 0xd3, 0x66, 0x0, 0x21, 0x0, 0x0, 0x0, 0x0, 0x0, 0x0, 0x0, 0x0,
0x0, 0x0, 0x0, 0x4, 0x0, 0x0, 0x4, 0x4, 0x25, 0x4a, 0x6d, 0x92, 0xb1, 0xb2, 0xb2, 0x8e, 0x25, 0x0, 0x0, 0x0,
0x0, 0x0, 0x0, 0x0, 0x0, 0x0, 0x0, 0x0, 0x1, 0x1, 0x1, 0x0, 0xb7, 0xb7, 0xd3, 0xb3, 0xd3, 0xb3, 0xb3, 0xb3,
0xcf, 0xef, 0xef, 0xf3, 0xf3, 0xd3, 0xd3, 0xd3, 0xd3, 0xd3, 0xd3, 0xb3, 0xb3, 0xd3, 0xd3, 0xd3, 0xd3, 0xd3, 0xd3, 0xd3,
0xd3, 0xf3, 0xf3, 0xf3, 0xee, 0xf3, 0xee, 0xef, 0xcf, 0x0, 0x21, 0x41, 0x0, 0x1, 0x0, 0x0, 0x0, 0x0, 0x0, 0x0,
0x0, 0x0, 0x0, 0x0, 0x24, 0x6d, 0x6d, 0x8d, 0xb1, 0xb1, 0xb0, 0xd1, 0xd1, 0xd1, 0xd1, 0xd2, 0xad, 0x89, 0x65, 0x20,
0x0, 0x0, 0x0, 0x0, 0x1, 0x0, 0x0, 0x0, 0x5, 0x1, 0x1, 0x21, 0x66, 0xd7, 0xd3, 0xb3, 0xb3, 0xb3, 0xb3, 0xd3,
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
0xb2, 0xb2, 0xb2, 0xb2, 0xb2, 0xb2, 0xb1, 0x91, 0x91, 0x8d, 0x6d, 0xb2, 0xb2, 0xb2, 0x91, 0xb2, 0x6d, 0xb2, 0x20, 0xda,
0xff, 0xff, 0xff, 0xff, 0xff, 0xfb, 0xff, 0xff, 0xff, 0xff, 0xff, 0xff, 0xff, 0xff, 0xff, 0xff, 0xff, 0xff, 0xff, 0xff,
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
};
