arkorobotics/L1DemosceneBoard/L1Demo-C-example/L1DemoProto.X/sprites.h

#define SPR_HEAD 5
#define SPR_OFF_WIDTH 0
#define SPR_OFF_HEIGHT 1
#define SPR_OFF_BITRES 2
#define SPR_OFF_TRANS 3
#define SPR_OFF_ROTATE 4
#define SPR_OFF_DATA 5

// SPRITE DEFINITIONS

#define MAX_SPRITES 8

#define SPR_FIRE_16_A 0
#define SPR_FIRE_16_B 1
#define SPR_FIRE_8_A 2
#define SPR_FIRE_8_B 3

#define SPR_INT_LAYER 4
#define SPR_INT_ONE 5
#define SPR_INT_BORD_A 6
#define SPR_INT_BORD_B 7

__prog__ uint8_t SpriteMap[] __attribute__((space(prog)))= {
// 16 x 16 fire animation
0x10, // width
0x10, // height
0x08, // bitres
0x03, // trans
0x00, // rotate
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
0x5d, 0x7e, 0x7e, 0x0, 0x14, 0x7e, 0x7e, 0x1c, 0x0, 0x0, 0x3c, 0x5e, 0x5d, 0x18, 0x4, 0x4, 0x4, 0x8, 0x0, 0x3c,
0x7e, 0x7e, 0x18, 0x0, 0x3c, 0x7e, 0x7e, 0x0, 0x0, 0x5d, 0x7e, 0x7e, 0x0, 0x10, 0x7e, 0x7e, 0x1c, 0x0, 0x0, 0x1c,
0x5e, 0x7e, 0x10, 0x0, 0xc, 0x10, 0x14, 0x4, 0x5d, 0x7e, 0x7e, 0x18, 0x8, 0x3c, 0x7e, 0x5e, 0x0, 0x0, 0x5d, 0x7e,
0x5e, 0x0, 0x10, 0x7e, 0x7e, 0x1c, 0x0, 0x0, 0x1c, 0x5e, 0x7e, 0x14, 0x4, 0x3d, 0x7e, 0x7e, 0x14, 0x5e, 0x7e, 0x7e,
0x7e, 0x7e, 0x7e, 0x7e, 0x5d, 0x0, 0x0, 0x5d, 0x7e, 0x7e, 0x4, 0x10, 0x7e, 0x7e, 0x3c, 0x0, 0x0, 0x1c, 0x7e, 0x7e,
0x7e, 0x7e, 0x5e, 0x7e, 0x7e, 0x18, 0x3c, 0x7e, 0x7e, 0x7e, 0x7e, 0x7e, 0x7e, 0x3c, 0x0, 0x0, 0x5d, 0x7e, 0x7e, 0x4,
0x14, 0x7e, 0x7e, 0x3c, 0x0, 0x0, 0x1c, 0x5d, 0x7e, 0x5d, 0x7e, 0x5e, 0x7e, 0x7e, 0x18, 0x1c, 0x5d, 0x3d, 0x3d, 0x5d,
0x5e, 0x3c, 0x1c, 0x0, 0x0, 0x3d, 0x5d, 0x3d, 0x4, 0x10, 0x3d, 0x3d, 0x3c, 0x0, 0x0, 0x1c, 0x14, 0x14, 0x7e, 0x5d,
0x5d, 0x3d, 0x5d, 0x10,

};
