arkorobotics/L1DemosceneBoard/L1Demo-C-example/L1DemoProto.X/testgfx.h

__eds__ uint8_t gfx_compressed[] __attribute__((space(eds) section("IMAGE"), address(0x4000))) = {
0x63,0x60,0x18,0x5,0x54,0x1,0x1,0xa1,0xa2,
0x98,0x42,0xa1,0xa1,0x8c,0x68,0x62,0x40,0x21,
0x74,0x85,0x21,0xa1,0x2b,0x57,0x65,0xa1,0x8a,
0x39,0x84,0x2e,0x5d,0xb5,0x6a,0x55,0x28,0xaa,
0x69,0x53,0x81,0x42,0xab,0xc2,0x50,0xc,0x4,
0xea,0x4,0x82,0x28,0x56,0x64,0xad,0x60,0x65,
0xab,0xa2,0x90,0x6d,0xe,0x58,0xa,0x15,0x43,
0xb2,0x25,0x60,0x25,0x54,0xc,0x49,0x61,0x8,
0x58,0x68,0xd5,0xac,0x55,0x61,0x8,0x13,0x21,
0xc6,0x1,0x1,0x92,0x13,0xa7,0x42,0x74,0x2e,
0x45,0x72,0xa2,0xc3,0x52,0x88,0x61,0x4b,0x91,
0x9c,0x8,0xb2,0x36,0x2b,0x14,0x2c,0x6,0x77,
0x22,0xc8,0x5a,0xa0,0xdb,0xc0,0x52,0xac,0x48,
0xd6,0x2,0x6d,0x4,0x1b,0x21,0x8a,0x24,0x26,
0xa,0xb5,0x2a,0xc,0x61,0x2d,0x58,0x4f,0x28,
0x52,0x38,0x0,0xc5,0xa2,0x40,0xcc,0x90,0x95,
0x70,0x4b,0x40,0xe6,0x80,0xc5,0x90,0x2c,0x1,
0x89,0x85,0xc1,0x83,0x47,0x14,0x55,0xc,0x6c,
0xa0,0x28,0xdc,0x79,0x10,0x16,0xc8,0xc0,0x30,
0xb8,0x18,0x2b,0x9c,0x5,0x15,0xc3,0x34,0x19,
0xe4,0x64,0x98,0x97,0x60,0xae,0x2,0x89,0x45,
0xa1,0xb9,0x94,0x61,0xa,0x42,0xc,0xce,0x9c,
0x8a,0xf0,0x25,0x36,0xb1,0xa9,0x98,0x62,0x70,
0x5f,0x22,0x89,0x85,0xc0,0xdd,0x32,0x15,0x1e,
0x42,0xa1,0xab,0x90,0xc4,0x20,0x21,0x14,0x30,
0x15,0x59,0x2c,0xb,0x1c,0x87,0xa1,0x88,0xc0,
0x7,0xc9,0x86,0xb2,0x82,0x92,0x2f,0x22,0xd6,
0xa7,0x82,0x63,0x17,0x9a,0x2e,0xa1,0xbe,0x4,
0xa7,0x16,0x50,0x7a,0x6,0xa7,0x6,0x46,0x84,
0x18,0x30,0x19,0x80,0x13,0x57,0x18,0x72,0x4a,
0x8b,0x2,0xa7,0xc1,0xac,0x50,0x94,0x14,0xb9,
0xa,0x39,0xf9,0x3a,0x4c,0x45,0x88,0xc1,0xd3,
0x10,0xc4,0x24,0x30,0x80,0xa7,0xb5,0x10,0xb8,
0xe6,0x28,0x51,0x44,0x8e,0x81,0x2b,0x43,0xa4,
0xe7,0x50,0xa8,0xc2,0xa8,0x50,0xe4,0x4c,0x9,
0x55,0x86,0x9c,0x69,0x20,0xa,0xc3,0x50,0x72,
0x2b,0xc4,0xfb,0x28,0xca,0x40,0xd9,0x77,0x25,
0x30,0x45,0x63,0x66,0x73,0x8c,0x7c,0x1e,0x12,
0x8a,0xa6,0x73,0xd8,0x82,0x50,0xcc,0x82,0xcf,
0x1,0x14,0x22,0x18,0x85,0x21,0xa8,0x28,0x40,
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
};
