arkorobotics/L1DemosceneBoard/(commit log)

2015-01-01 Added L1 Demoscene Board PCB
    Added L1 Demoscene Board PCB
    [L1Demoscene_v4.brd, L1Demoscene_v4.sch]
2015-01-01 Color bar test
    color bar test, framebuffer still in the works, this is not complete,
    but compiles.
2015-02-14 L1 Demoscene Board Example with flames and music
    Written by Datagram and Hotdogs, this demo displays sprites, draws
    animated squares and plays a simple song.
2015-02-15 fixed display issue
    fixed display issue
    [main.c]
2017-06-25 Added panelized PCBs and production BOM
    Added panelized PCBs and production BOM
    [L1Demoboard_BOM.xlsx, arko_l1demo_partlist.xlsx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]
